minisystem/M4/Panel/M4_hole_centres.dxf

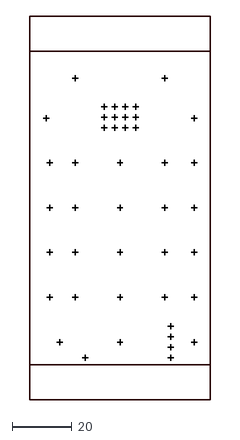
[picture p1: CAD file, 2017-03-15]
Panel/M4_hole_centres.dxf
60.6 x 128.5
