minisystem/M4/M4.kicad_pcb

## KiCad design M4.kicad_pcb (2017-03-21)

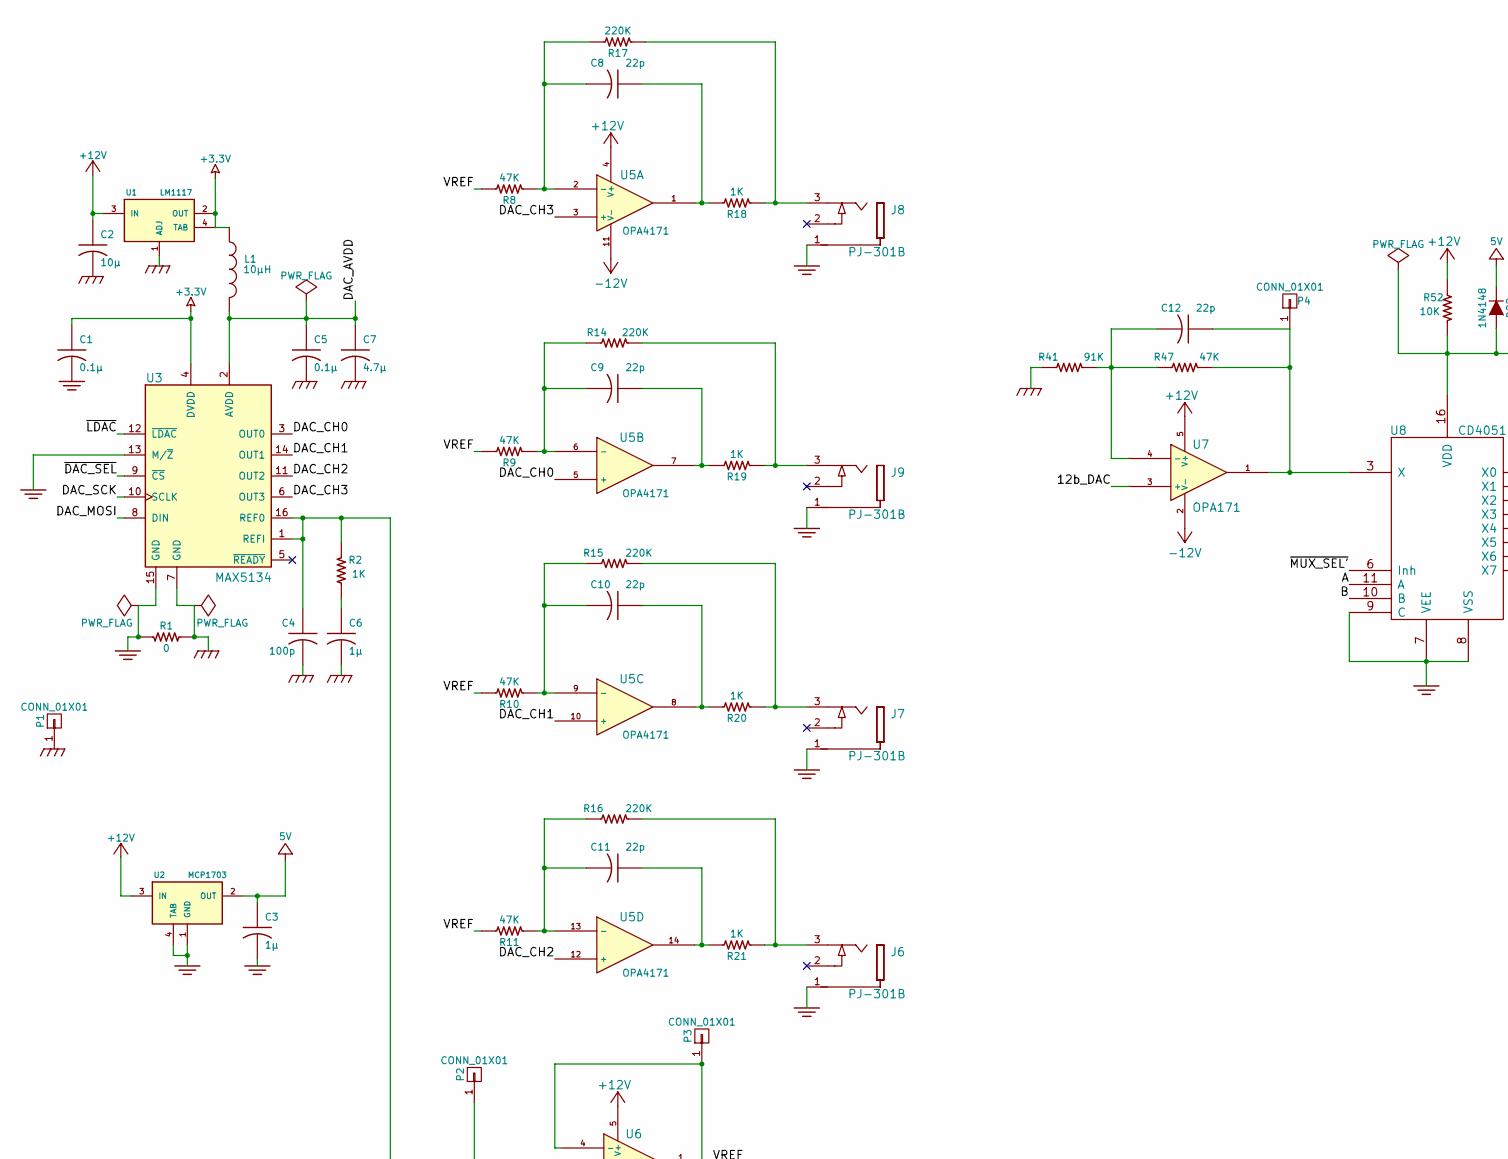
[picture p2: schematic M4.sch, part in row 1, column 1]

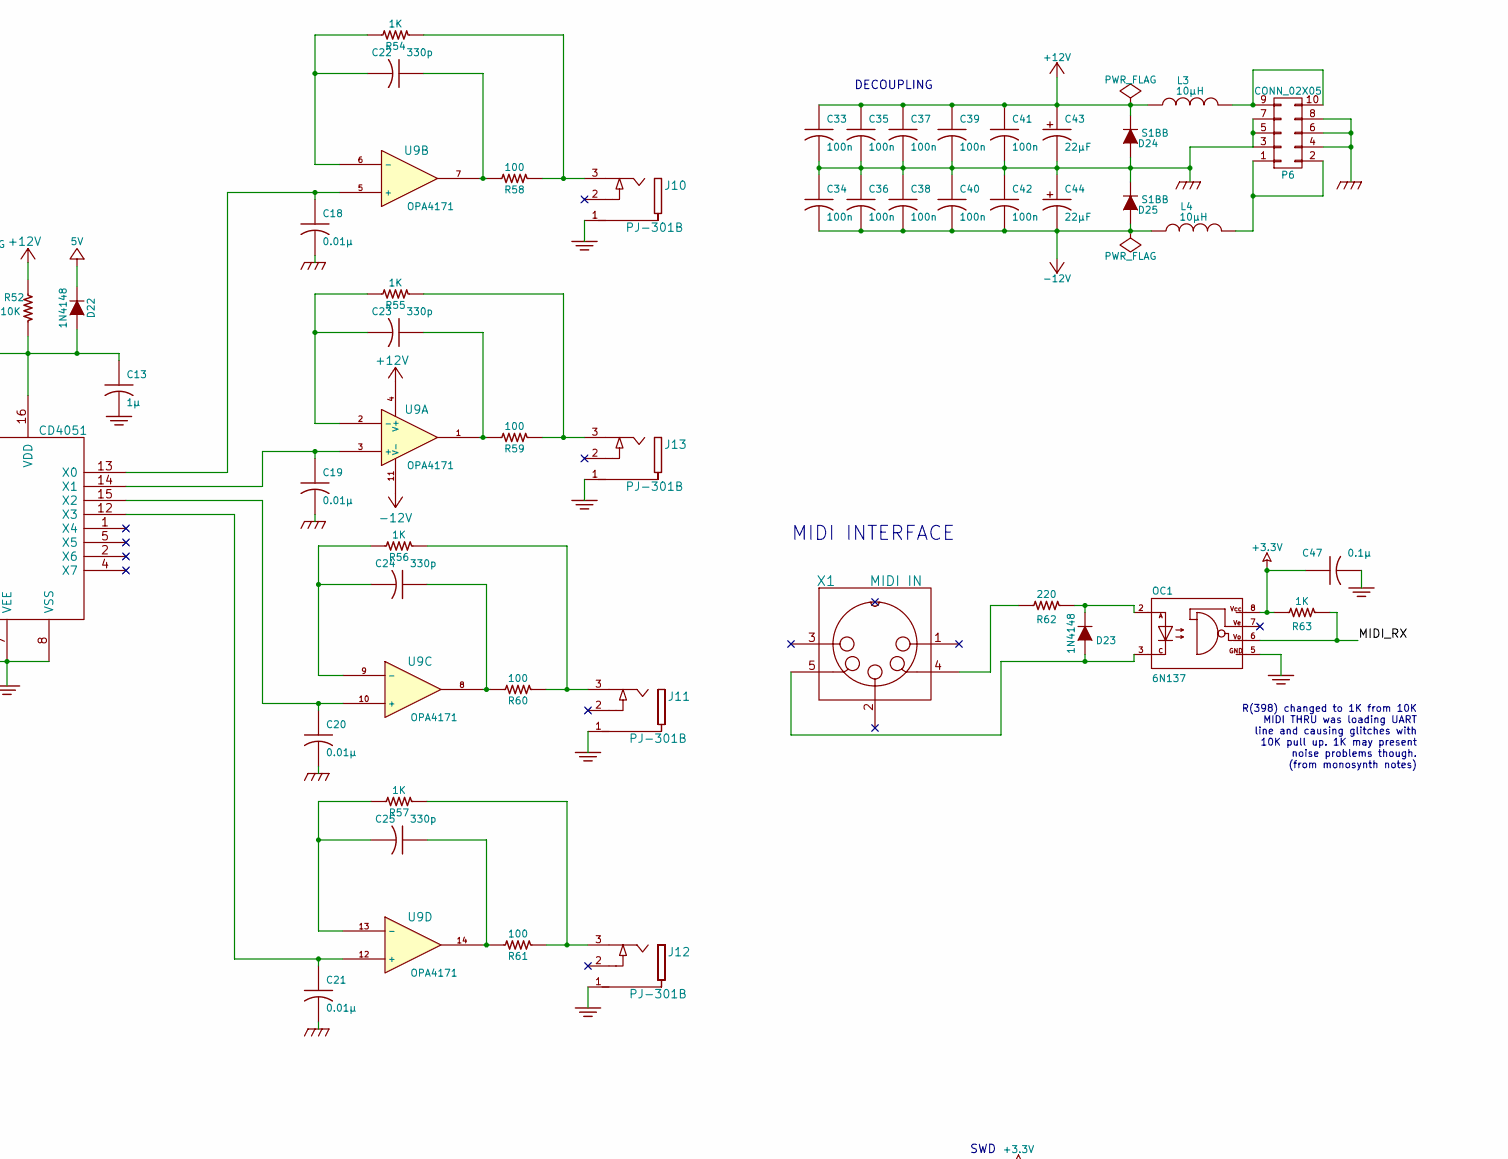
[picture p3: schematic M4.sch, part in row 1, column 2]

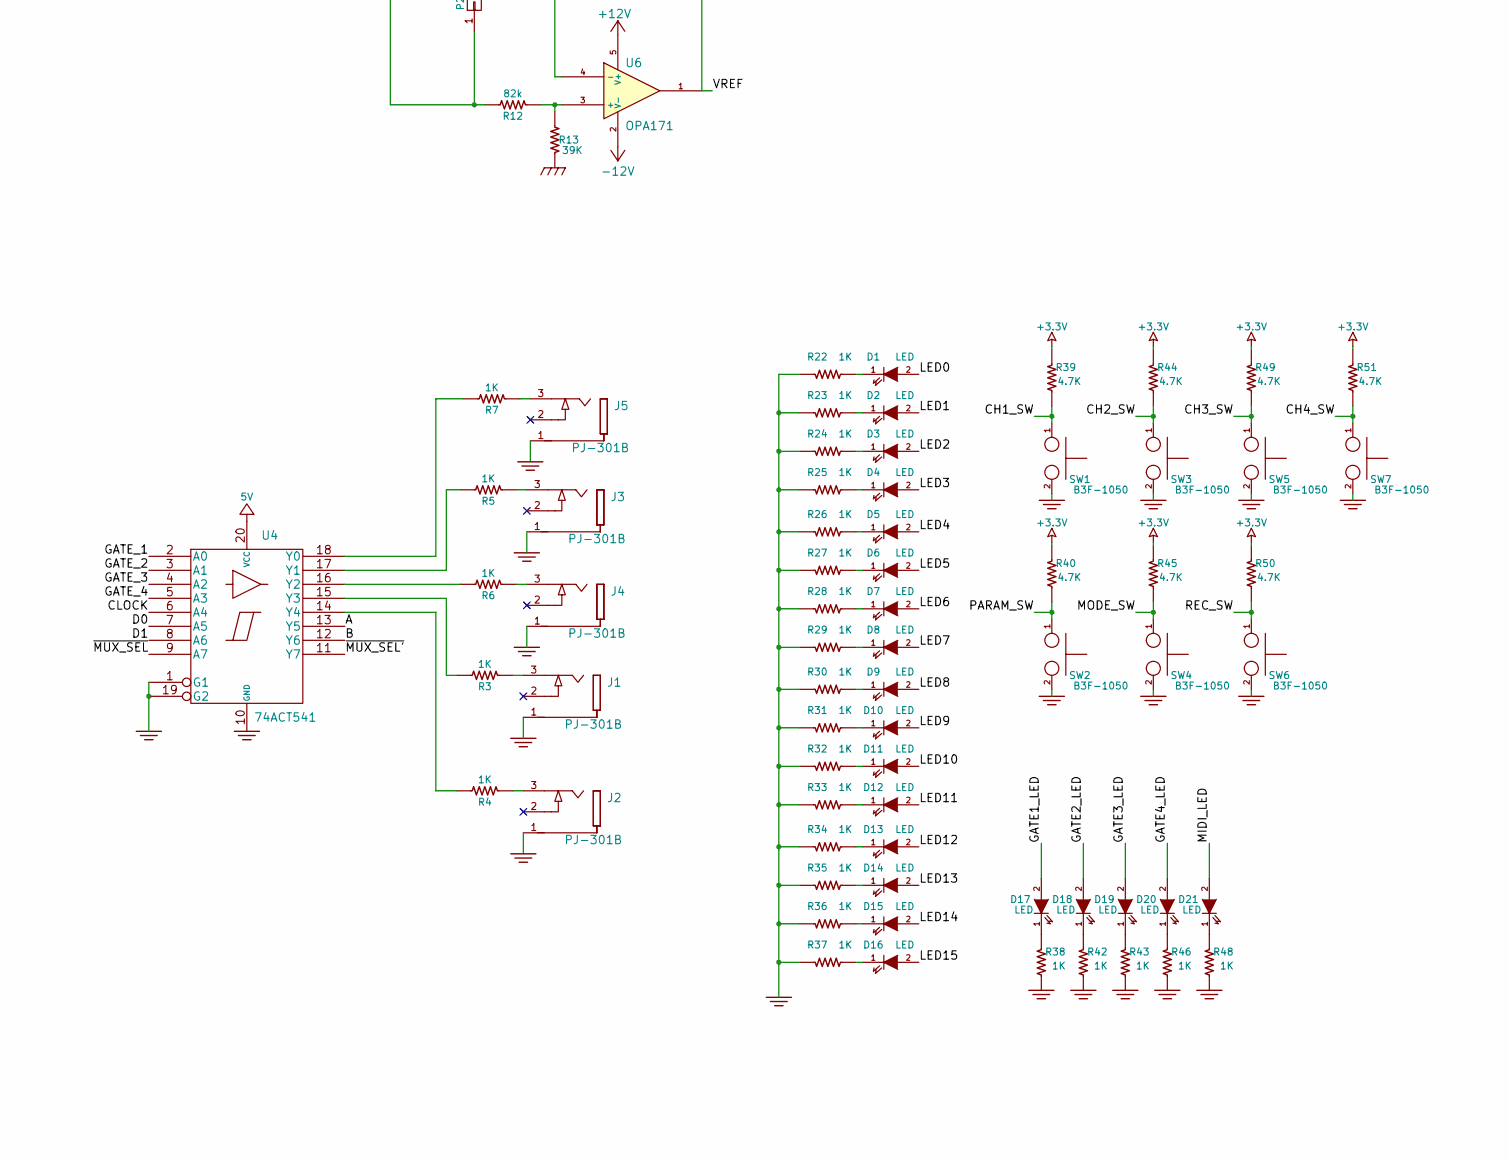
[picture p4: schematic M4.sch, part in row 2, column 1]

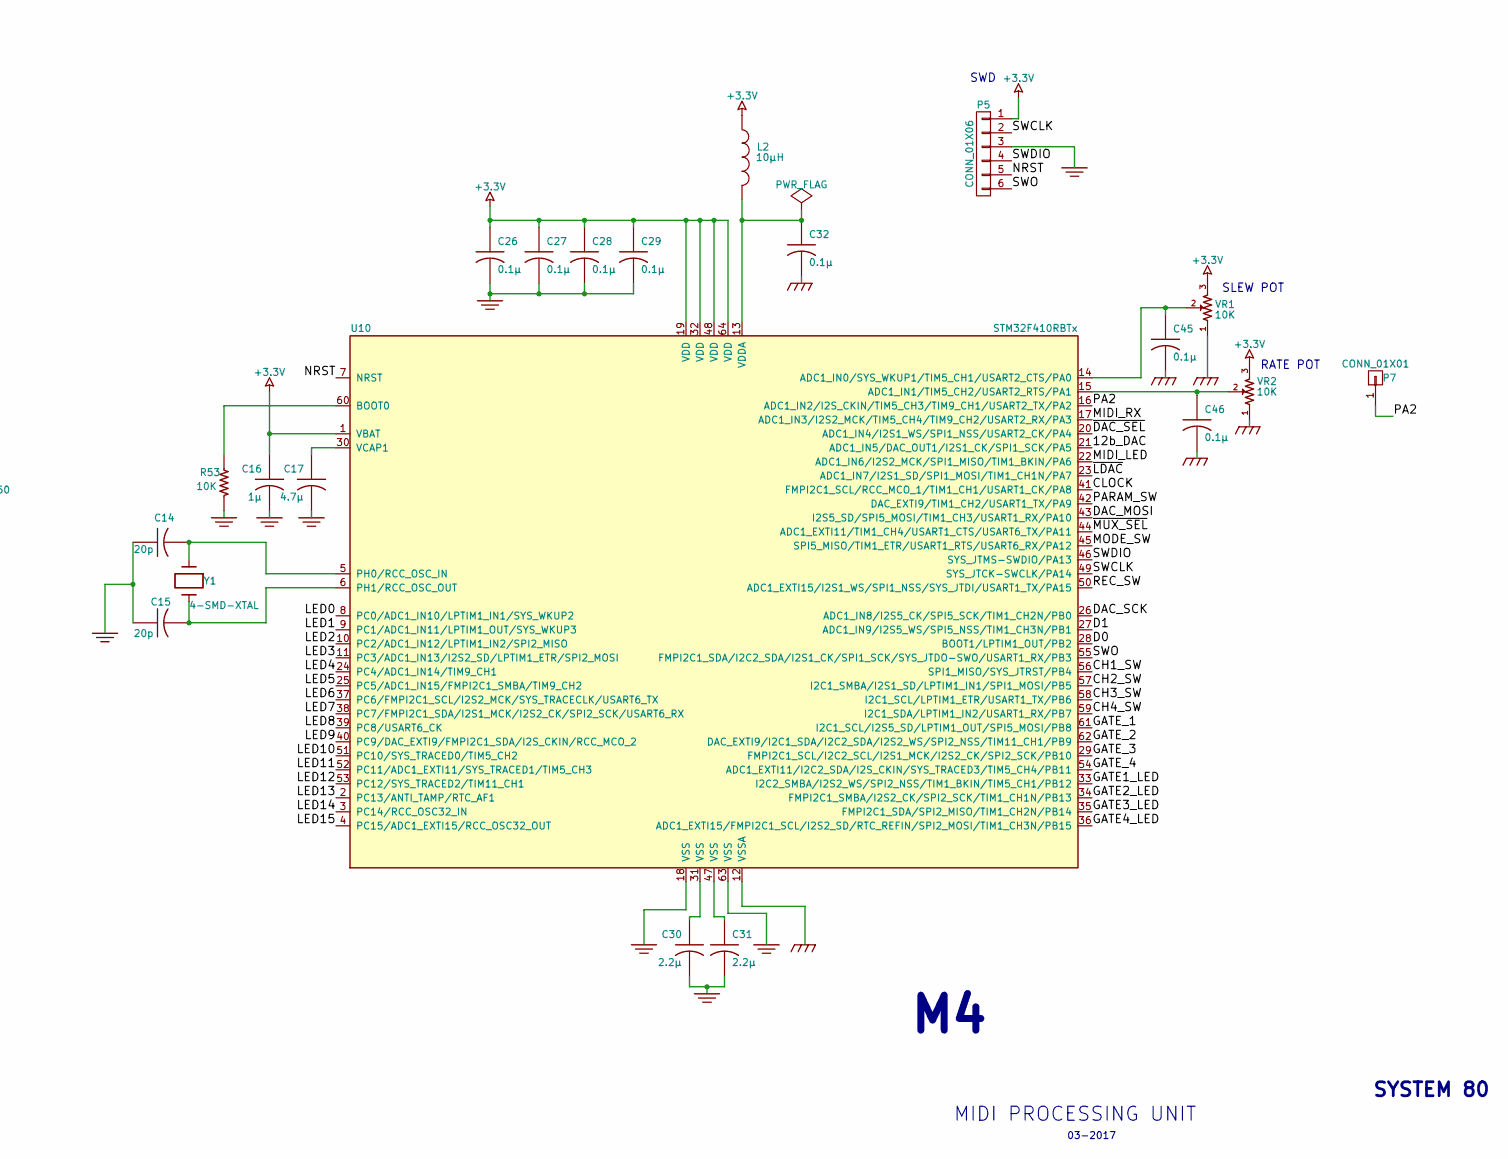
[picture p5: schematic M4.sch, part in row 2, column 2]

Parts:
C1, C5, C26, C27, C28, C29, C32, C45, C46: 0.1μ; SM0603-C-JRL
C2: 10μ; SM0805-HAND
C3, C6, C13, C16: 1μ; SM0603-C-JRL
C4: 100p; SM0603-C-JRL
C7: 4.7μ; SM0805-HAND
C8, C9, C10, C11, C12: 22p; SM0603-C-JRL
C14, C15: 20p; SM0603-C-JRL
C17: 4.7μ; SM0603-C-JRL
C18, C19, C20, C21: 0.01μ; SM0603-C-JRL
C22, C23, C24, C25: 330p; SM0603-C-JRL
C30, C31: 2.2μ; SM0603-C-JRL
C33, C34, C35, C36, C37, C38, C39, C40, C41, C42: 100n; SM0603-C-JRL
C43, C44: 22μF; jrl_c_elec_5x5.3; Part Number UWJ1E100MCL1GB
C47: 0.1µ; SM0603-C-JRL
D1, D2, D3, D4, D5, D6, D7, D8, D9, D10, D11, D12, D13, D14, D15, D16, D17, D18, D19, D20, D21: LED; 1.8MM-LED-TLUG240
D22, D23: 1N4148; SOD323-C1A2
D24, D25: S1BB; SMB-1C2A
J1, J2, J3, J4, J5, J6, J7, J8, J9, J10, J11, J12, J13: PJ-301B; PJ-301B-JACK-SLOTS
L1, L2, L3, L4: 10μH; SM0603-R-JRL
OC1: 6N137; 8-SMD
P1: CONN_01X01; TEST_POINT_LOOP_4592
P2, P3, P4, P7: CONN_01X01; TEST_POINT_SMALL
P5: CONN_01X06; Pin_Header_Straight_1x06_Pitch2.54mm
P6: CONN_02X05; Pin_Header_Straight_2x05_Pitch2.54mm
R1: 0; SM0603-R-JRL
R2, R3, R4, R5, R6, R7, R18, R19, R20, R21, R22, R23, R24, R25, R26, R27, R28, R29, R30, R31, R32, R33, R34, R35, R36, R37, R38, R42, R43, R46, R48, R54, R55, R56, R57, R63: 1K; SM0603-R-JRL
R8, R9, R10, R11, R47: 47K; SM0603-R-JRL
R12: 82k; SM0603-R-JRL
R13: 39K; SM0603-R-JRL
R14, R15, R16, R17: 220K; SM0603-R-JRL
R39, R40, R44, R45, R49, R50, R51: 4.7K; SM0603-R-JRL
R41: 91K; SM0603-R-JRL
R52, R53: 10K; SM0603-R-JRL
R58, R59, R60, R61: 100; SM0603-R-JRL
R62: 220; SM0603-R-JRL
SW1, SW2, SW3, SW4, SW5, SW6, SW7: B3F-1050; B3F-1050-OMRON
U1: LM1117; SOT-223
U2: MCP1703; SOT-223
U3: MAX5134; TSSOP-16_4.4x5mm_Pitch0.65mm
U4: 74ACT541; TSSOP-20_4.4x6.5mm_Pitch0.65mm
U5, U9: OPA4171; TSSOP-14_4.4x5mm_Pitch0.65mm
U6, U7: OPA171; SOT-23-5
U8: CD4051; TSSOP-16_4.4x5mm_Pitch0.65mm_jrl
U10: STM32F410RBTx; LQFP-64_10x10mm_Pitch0.5mm
VR1, VR2: 10K; RV16A-41-JRL
X1: MIDI IN; SD-50BV-5DIN
Y1: 4-SMD-XTAL

Connections:
+3V3: C1.1, C16.1, C26.1, C27.1, C28.1, C29.1, C47.1, L1.1, L2.1, OC1.8, P5.1, R39.1, R40.1, R44.1, R45.1, R49.1, R50.1, R51.1, R63.2, U1.2 (OUT), U1.4 (TAB), U3.4 (DVDD), U10.1 (VBAT), U10.19 (VDD), U10.32 (VDD), U10.48 (VDD), U10.64 (VDD), VR1.3, VR2.3
+5V: C3.1, D22.1 (K), U2.2 (OUT), U4.20 (VCC)
+12V: C2.1, C33.1, C35.1, C37.1, C39.1, C41.1, C43.1 (+), D24.1 (K), L3.1, R52.1, U1.3 (IN), U2.3 (IN), U5.4 (V+), U6.5 (V+), U7.5 (V+), U9.4 (V+)
-12V: C34.2, C36.2, C38.2, C40.2, C42.2, C44.2 (-), D25.2 (A), L4.1, U5.11 (V-), U6.2 (V-), U7.2 (V-), U9.11 (V-)
/12b_DAC: U7.3 (+), U10.21 (ADC1_IN5/DAC_OUT1/I2S1_CK/SPI1_SCK/PA5)
/A: U4.13 (Y5), U8.11 (A)
/B: U4.12 (Y6), U8.10 (B)
/CH1_SW: R39.2, SW1.1, U10.56 (SPI1_MISO/SYS_JTRST/PB4)
/CH2_SW: R44.2, SW3.1, U10.57 (I2C1_SMBA/I2S1_SD/LPTIM1_IN1/SPI1_MOSI/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)
/CH3_SW: R49.2, SW5.1, U10.58 (I2C1_SCL/LPTIM1_ETR/USART1_TX/PB6)
/CH4_SW: R51.2, SW7.1, U10.59 (I2C1_SDA/LPTIM1_IN2/USART1_RX/PB7)
/CLOCK: U4.6 (A4), U10.41 (FMPI2C1_SCL/RCC_MCO_1/TIM1_CH1/USART1_C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)
/D0: U4.7 (A5), U10.28 (BOOT1/LPTIM1_OUT/PB2)
/D1: U4.8 (A6), U10.27 (ADC1_IN9/I2S5_WS/SPI5_NSS/TIM1_CH3N/PB1)
/DAC_AVDD: C5.1, C7.1, L1.2, U3.2 (AVDD)
/DAC_CH0: U3.3 (OUT0), U5.5 (+)
/DAC_CH1: U3.14 (OUT1), U5.10 (+)
/DAC_CH2: U3.11 (OUT2), U5.12 (+)
/DAC_CH3: U3.6 (OUT3), U5.3 (+)
/DAC_MOSI: U3.8 (DIN), U10.43 (I2S5_SD/SPI5_MOSI/TIM1_CH3/USART1_RX/PA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)
/DAC_SCK: U3.10 (SCLK), U10.26 (ADC1_IN8/I2S5_CK/SPI5_SCK/TIM1_CH2N/PB0)
/GATE1_LED: D17.2 (A), U10.33 (I2C2_SMBA/I2S2_WS/SPI2_NSS/TIM1_BKIN/TI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)
/GATE2_LED: D18.2 (A), U10.34 (FMPI2C1_SMBA/I2S2_CK/SPI2_SCK/TIM1_CH1N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)
/GATE3_LED: D19.2 (A), U10.35 (FMPI2C1_SDA/SPI2_MISO/TIM1_CH2N/PB14)
/GATE4_LED: D20.2 (A), U10.36 (ADC1_EXTI15/FMPI2C1_SCL/I2S2_SD/RTC_REF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)
/GATE_1: U4.2 (A0), U10.61 (I2C1_SCL/I2S5_SD/LPTIM1_OUT/SPI5_MOSI/P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)
/GATE_2: U4.3 (A1), U10.62 (DAC_EXTI9/I2C1_SDA/I2C2_SDA/I2S2_WS/SPI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)
/GATE_3: U4.4 (A2), U10.29 (FMPI2C1_SCL/I2C2_SCL/I2S1_MCK/I2S2_CK/S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)
/GATE_4: U4.5 (A3), U10.54 (ADC1_EXTI11/I2C2_SDA/I2S_CKIN/SYS_TRACE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)
/LED0: D1.2 (A), U10.8 (PC0/ADC1_IN10/LPTIM1_IN1/SYS_WKUP2)
/LED1: D2.2 (A), U10.9 (PC1/ADC1_IN11/LPTIM1_OUT/SYS_WKUP3)
/LED2: D3.2 (A), U10.10 (PC2/ADC1_IN12/LPTIM1_IN2/SPI2_MISO)
/LED3: D4.2 (A), U10.11 (PC3/ADC1_IN13/I2S2_SD/LPTIM1_ETR/SPI2_M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)
/LED4: D5.2 (A), U10.24 (PC4/ADC1_IN14/TIM9_CH1)
/LED5: D6.2 (A), U10.25 (PC5/ADC1_IN15/FMPI2C1_SMBA/TIM9_CH2)
/LED6: D7.2 (A), U10.37 (PC6/FMPI2C1_SCL/I2S2_MCK/SYS_TRACECLK/U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)
/LED7: D8.2 (A), U10.38 (PC7/FMPI2C1_SDA/I2S1_MCK/I2S2_CK/SPI2_S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)
/LED8: D9.2 (A), U10.39 (PC8/USART6_CK)
/LED9: D10.2 (A), U10.40 (PC9/DAC_EXTI9/FMPI2C1_SDA/I2S_CKIN/RCC_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)
/LED10: D11.2 (A), U10.51 (PC10/SYS_TRACED0/TIM5_CH2)
/LED11: D12.2 (A), U10.52 (PC11/ADC1_EXTI11/SYS_TRACED1/TIM5_CH3)
/LED12: D13.2 (A), U10.53 (PC12/SYS_TRACED2/TIM11_CH1)
/LED13: D14.2 (A), U10.2 (PC13/ANTI_TAMP/RTC_AF1)
/LED14: D15.2 (A), U10.3 (PC14/RCC_OSC32_IN)
/LED15: D16.2 (A), U10.4 (PC15/ADC1_EXTI15/RCC_OSC32_OUT)
/MIDI_LED: D21.2 (A), U10.22 (ADC1_IN6/I2S2_MCK/SPI1_MISO/TIM1_BKIN/P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)
/MIDI_RX: OC1.6, R63.1, U10.17 (ADC1_IN3/I2S2_MCK/TIM5_CH4/TIM9_CH2/USA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)
/MODE_SW: R45.2, SW4.1, U10.45 (SPI5_MISO/TIM1_ETR/USART1_RTS/USART6_RX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)
/NRST: P5.5, U10.7 (NRST)
/PA2: P7.1, U10.16 (ADC1_IN2/I2S_CKIN/TIM5_CH3/TIM9_CH1/USA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)
/PARAM_SW: R40.2, SW2.1, U10.42 (DAC_EXTI9/TIM1_CH2/USART1_TX/PA9)
/REC_SW: R50.2, SW6.1, U10.50 (ADC1_EXTI15/I2S1_WS/SPI1_NSS/SYS_JTDI/U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)
/SWCLK: P5.2, U10.49 (SYS_JTCK-SWCLK/PA14)
/SWDIO: P5.4, U10.46 (SYS_JTMS-SWDIO/PA13)
/SWO: P5.6, U10.55 (FMPI2C1_SDA/I2C2_SDA/I2S1_CK/SPI1_SCK/S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)
/VREF: P3.1, R8.2, R9.2, R10.2, R11.2, U6.1, U6.4 (-)
/~DAC_SEL: U3.9 (~CS~), U10.20 (ADC1_IN4/I2S1_WS/SPI1_NSS/USART2_CK/PA4)
/~LDAC: U3.12 (~LDAC~), U10.23 (ADC1_IN7/I2S1_SD/SPI1_MOSI/TIM1_CH1N/PA7)
/~MUX_SEL: U4.9 (A7), U10.44 (ADC1_EXTI11/TIM1_CH4/USART1_CTS/USART6_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)
/~MUX_SEL': U4.11 (Y7), U8.6 (Inh)
unnamed: C4.1, P2.1, R2.1, R12.2, U3.1 (REFI), U3.16 (REF0)
unnamed: C6.1, R2.2
unnamed: C8.1, R18.2, U5.1
unnamed: C8.2, R8.1, R17.2, U5.2 (-)
unnamed: C9.1, R19.2, U5.7
unnamed: C9.2, R9.1, R14.2, U5.6 (-)
unnamed: C10.1, R20.2, U5.8
unnamed: C10.2, R10.1, R15.2, U5.9 (-)
unnamed: C11.1, R21.2, U5.14
unnamed: C11.2, R11.1, R16.2, U5.13 (-)
unnamed: C12.1, P4.1, R47.1, U7.1, U8.3 (X)
unnamed: C12.2, R41.1, R47.2, U7.4 (-)
unnamed: C13.1, D22.2 (A), R52.2, U8.16 (VDD)
unnamed: C14.2, U10.5 (PH0/RCC_OSC_IN), Y1.1
unnamed: C15.2, U10.6 (PH1/RCC_OSC_OUT), Y1.3
unnamed: C17.1, U10.30 (VCAP1)
unnamed: C18.1, U8.13 (X0), U9.5 (+)
unnamed: C19.1, U8.14 (X1), U9.3 (+)
unnamed: C20.1, U8.15 (X2), U9.10 (+)
unnamed: C21.1, U8.12 (X3), U9.12 (+)
unnamed: C22.1, R58.2, U9.7
unnamed: C22.2, R54.2, U9.6 (-)
unnamed: C23.1, R59.2, U9.1
unnamed: C23.2, R55.2, U9.2 (-)
unnamed: C24.1, R60.2, U9.8
unnamed: C24.2, R56.2, U9.9 (-)
unnamed: C25.1, R61.2, U9.14
unnamed: C25.2, R57.2, U9.13 (-)
unnamed: C30.1, U10.31 (VSS)
unnamed: C31.1, U10.47 (VSS)
unnamed: C32.1, L2.2, U10.13 (VDDA)
unnamed: C45.1, U10.14 (ADC1_IN0/SYS_WKUP1/TIM5_CH1/USART2_CTS/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), VR1.2
unnamed: C46.1, U10.15 (ADC1_IN1/TIM5_CH2/USART2_RTS/PA1), VR2.2
unnamed: D1.1 (K), R22.2
unnamed: D2.1 (K), R23.2
unnamed: D3.1 (K), R24.2
unnamed: D4.1 (K), R25.2
unnamed: D5.1 (K), R26.2
unnamed: D6.1 (K), R27.2
unnamed: D7.1 (K), R28.2
unnamed: D8.1 (K), R29.2
unnamed: D9.1 (K), R30.2
unnamed: D10.1 (K), R31.2
unnamed: D11.1 (K), R32.2
unnamed: D12.1 (K), R33.2
unnamed: D13.1 (K), R34.2
unnamed: D14.1 (K), R35.2
unnamed: D15.1 (K), R36.2
unnamed: D16.1 (K), R37.2
unnamed: D17.1 (K), R38.1
unnamed: D18.1 (K), R42.1
unnamed: D19.1 (K), R43.1
unnamed: D20.1 (K), R46.1
unnamed: D21.1 (K), R48.1
unnamed: D23.1 (K), OC1.2, R62.1
unnamed: D23.2 (A), OC1.3, X1.5
unnamed: J1.3, R3.1
unnamed: J2.3, R4.1
unnamed: J3.3, R5.1
unnamed: J4.3, R6.1
unnamed: J5.3, R7.1
unnamed: J6.3, R16.1, R21.1
unnamed: J7.3, R15.1, R20.1
unnamed: J8.3, R17.1, R18.1
unnamed: J9.3, R14.1, R19.1
unnamed: J10.3, R54.1, R58.1
unnamed: J11.3, R56.1, R60.1
unnamed: J12.3, R57.1, R61.1
unnamed: J13.3, R55.1, R59.1
unnamed: L3.2, P6.9, P6.10
unnamed: L4.2, P6.1, P6.2
unnamed: R3.2, U4.15 (Y3)
unnamed: R4.2, U4.14 (Y4)
unnamed: R5.2, U4.17 (Y1)
unnamed: R6.2, U4.16 (Y2)
unnamed: R7.2, U4.18 (Y0)
unnamed: R12.1, R13.2, U6.3 (+)
unnamed: R53.1, U10.60 (BOOT0)
unnamed: R62.2, X1.4

Notes on the sheet:
DECOUPLING
MIDI INTERFACE
R(398) changed to 1K from 10K MIDI THRU was loading UART line and causing glitches with 10K pull up. 1K may present noise problems though. (from monosynth notes)
SWD
SLEW POT
RATE POT
SYSTEM 80
03-2017
MIDI PROCESSING UNIT

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
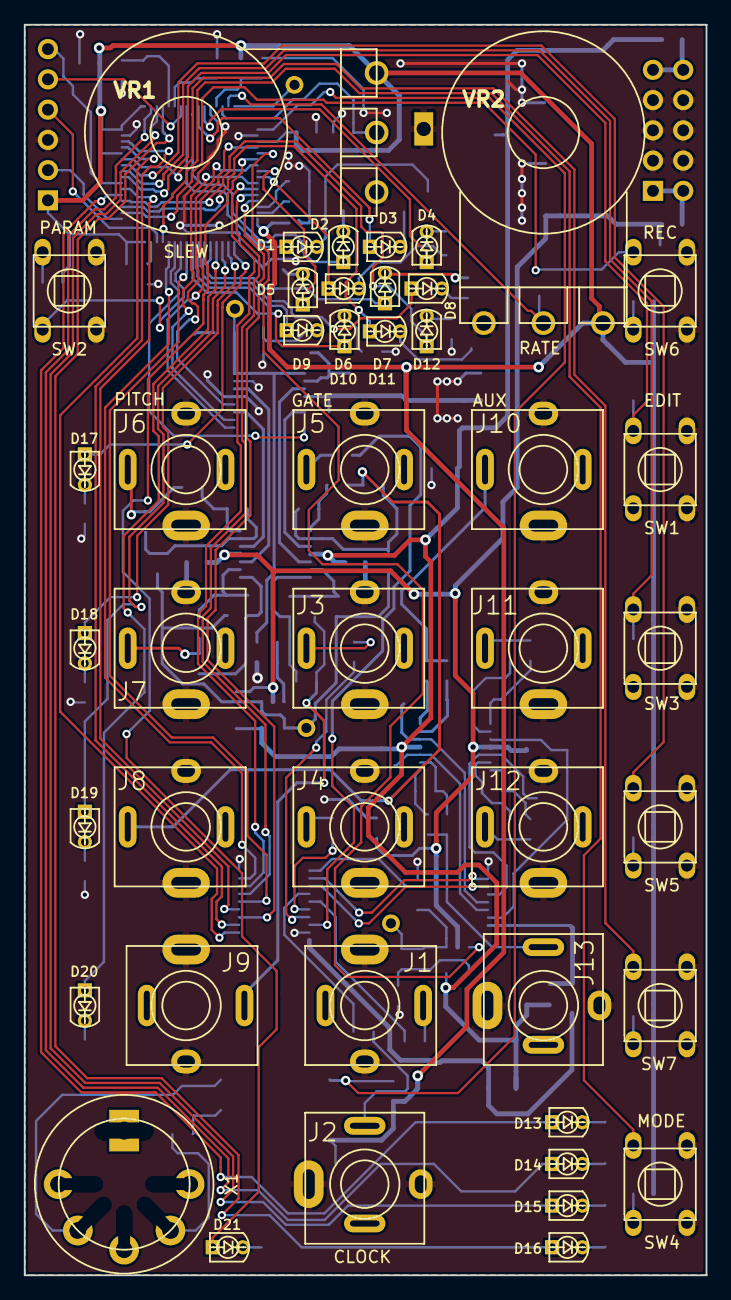
[picture p6: board M4.kicad_pcb from above]

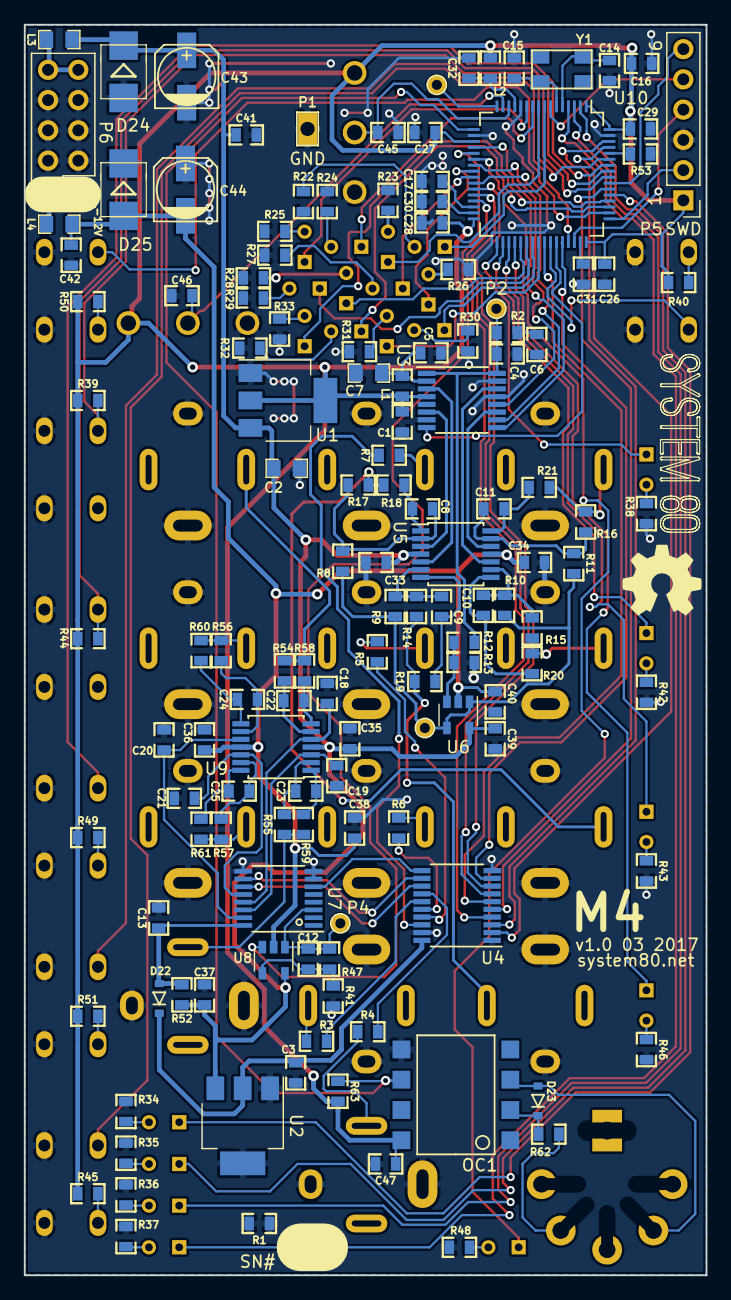
[picture p7: board M4.kicad_pcb from below]

Board: 2 copper layers, 57.2 x 105.0 mm, 181 parts (137 on the bottom side), 140 nets.
