minisystem/M4/(commit log)

2017-03-14 almost finished schematic capture
    [M4.sch]
2017-03-14 updated panel svg for Inkscape 0.91, schematic annotated and ERC complete
    [M4.sch]
2017-03-15 placed pots/jacks/switches on PCB. not a lot of room left for ICs
    [M4.sch, M4_hole_centres.dxf]
2017-03-17 basically routed. need to delete excess decoupling caps and decide about whether external sw pull up resistors are necessary - probably not and need to be deleted
    [M4.kicad_pcb, M4.sch]
2017-03-18 updated some 3D part assignments
    [M4.kicad_pcb]
2017-03-18 changed LED models to TLUGX240
    [M4.kicad_pcb, M4.sch]
2017-03-18 tidied up front silkscreen
    [M4.kicad_pcb]
2017-03-19 routing and silkscreen done. just need to check everything and then ready to order
    [M4.kicad_pcb]
2017-03-21 going through final checking stages, then will be ready to order PCB
    [M4.kicad_pcb]
2017-03-21 generated gerbers, ready to order
    [M4.kicad_pcb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]
2017-03-22 PCBs ordered
